MikeBusuttil/kitchenlighting/12v/references/spool.png

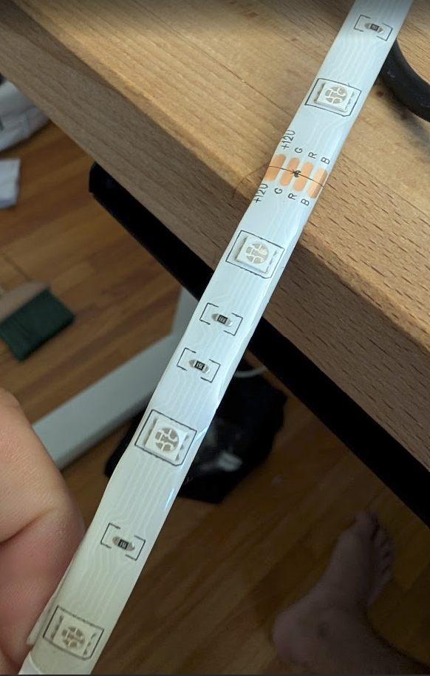
12v/references/spool.png
