MikeBusuttil/kitchenlighting/12v/references/driver.png

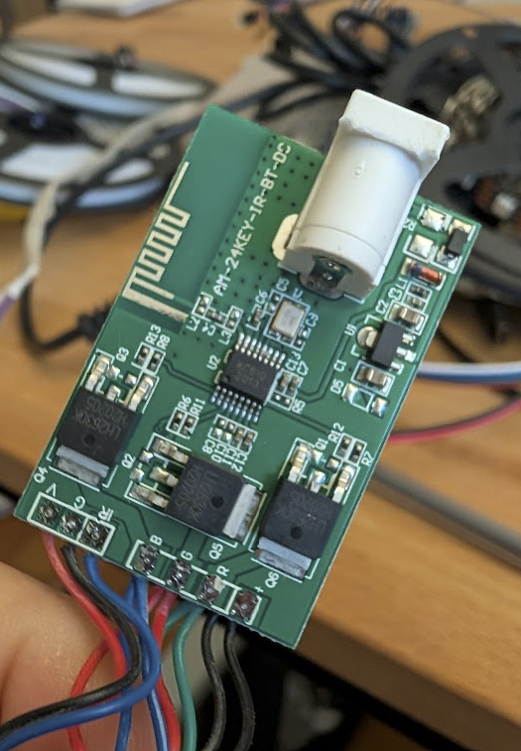
12v/references/driver.png
