MikeBusuttil/kitchenlighting/12v/shopping.csv

status | quantity_needed | suggested_order_quantity | description | manufacturer_part | estimated_order_cost_CAD | purchase_url | notes
minimum only | 3 | 3 | N-channel MOSFET; SOT-23-3; 30 V; direct 3.3 V control | AO3400A | 2.49 | https://www.digikey.ca/en/products/detail/alpha-omega-semiconductor-inc/AO3400A/1855772 | Minimum Q1-Q3, Alpha & Omega Semiconductor part. Solder each onto a SparkFun 00717 adapter listed below. SOT-23 pins: 1=G, 2=S, 3=D. Maximum on-resistance 48 milliohms at VGS=2.5 V, ID=3 A, 25 C. The headline 5.7 A rating depends on PCB copper and thermal conditions; it is not a breadboard or adapter rating. Keep the 25 cm/0.30 A combined load limit. DigiKey 785-1000-1-ND cut tape, CAD0.83 each; in stock when checked 2026-10-16. Datasheet: https://www.aosmd.com/res/data_sheets/AO3400A.pdf
minimum only | 3 | 3 | SOT-23 to DIP adapter; bare PCB; 0.300-inch row spacing | 00717 | 5.61 | https://www.digikey.ca/en/products/detail/sparkfun-electronics/00717/5318740 | Minimum A1-A3: SparkFun BOB-00717, DigiKey 1568-00717-ND. CAD1.87 each, CAD5.61 for three; in stock when checked 2026-10-16. Solder one AO3400A onto each bare board and fit two 61300311121 straight 1x3 headers per board, listed separately below. Board is 0.34 x 0.46 inch (8.64 x 11.68 mm), with two header rows 0.300 inch (7.62 mm) apart and 0.100-inch (2.54 mm) pin pitch. Mount headers underneath in columns e/f across the breadboard centre gap: A1 rows 42-44, A2 rows 48-50, A3 rows 54-56. Component-side top view, single drain lead facing left: Q1 source f42, drain e43, gate f44; Q2 source f48, drain e49, gate f50; Q3 source f54, drain e55, gate f56. Leave the other three pads empty and their header bank/rows isolated. The six-pad adapter numbering differs from the three-pin AO3400A package numbering; follow the drawn gate, drain and source connections. Inspect actual copper routes and check continuity before applying power. No current rating for the adapter is inferred from the MOSFET rating. Included in generated min.csv. Manufacturer: https://www.sparkfun.com/sparkfun-sot23-to-dip-adapter.html ; schematic: https://cdn.sparkfun.com/datasheets/BreakoutBoards/SparkFun_SOT23-DIP-Adapter-v10.pdf
minimum only | 6 | 6 | Straight male 1x3 header; 2.54 mm pitch; two per adapter | 61300311121 | 1.14 | https://www.digikey.ca/en/products/detail/w%C3%BCrth-elektronik/61300311121/4846825 | Minimum H1-H6: Wurth Elektronik WR-PHD, DigiKey 732-5316-ND. Two headers per SparkFun 00717 board, six total. Through-hole, straight, single row, three positions at 2.54 mm pitch; 6 mm mating pins. Solder the headers to the adapters with their long pins pointing down into the breadboard. CAD0.19 each, CAD1.14 for six; in stock when checked 2026-10-16. Included in generated min.csv.
minimum only | 3 | 10 | 2.2 kohm 1/4 W axial resistor | CF14JT2K20 | 0.43 | https://www.digikey.ca/en/products/detail/stackpole-electronics-inc/CF14JT2K20/1830358 | Minimum R1-R3: one series resistor from each Nano PWM output to its AO3400A gate; limits initial 3.3 V gate-charge current to approximately 1.5 mA. No pulldown resistors are fitted. Intended for the default low-frequency PWM. DigiKey CF14JT2K20CT-ND cut tape, ten cost CAD0.43, cheaper than three at CAD0.16 each; in stock when checked 2026-10-16. Seven are spares; only three are installed.
best-practice only | 3 | 3 | N-channel MOSFET; TO-220 | IRFZ44NPBF | 6.90 | https://www.digikey.ca/en/products/detail/infineon-technologies/IRFZ44NPBF/811772 | Best-practice Q1-Q3 only; minimum uses AO3400A on SparkFun 00717 DIP adapters. Use TC4427A gate drivers, not Nano direct gate drive. Front face, legs down: G-D-S; tab=D. Leads have 2.54 mm pitch but must occupy DIFFERENT ROWS. Fit varies: do not force thick TO-220 leads into breadboard; suitable pin adapters may be needed. MOSFET capacity does not increase the 25 cm/0.30 A combined breadboard load limit.
best-practice only | 2 | 2 | Dual non-inverting gate driver; DIP-8 | TC4427ACPA | 5.68 | https://www.digikey.ca/en/products/detail/microchip-technology/TC4427ACPA/418665 | Best-practice only; minimum uses direct Nano gate control. 12 V supply; accepts Nano 3.3 V signals. Three channels used; ground fourth input and leave fourth output open.
minimum only | 2 | 2 | Female RJ-11/RJ-14 modular jack; 6P4C; vertical through-hole | 615004144121 | 2.84 | https://www.digikey.ca/fr/products/detail/w%C3%BCrth-elektronik/615004144121/2627288 | J1/J2 in the minimum diagram; parallel RGB strip connections for the short-strip test. Both ports: pin 2 = +12 V, pin 3 = R, pin 4 = G, pin 5 = B. Positive pins use soldered pigtails from J0.1, bypassing breadboard contacts. Breadboard mounting is conceptual, not the physical footprint; use adapters or soldered leads if needed. Combined strip load remains at most 25 cm/0.30 A total. DigiKey 732-3172-ND; CAD 1.42 each checked 2026-10-16, before tax/shipping. Included in generated min.csv.
best-practice only | 3 | 10 | 100 ohm 1/4 W axial resistor | CF14JT100R | 0.43 | https://www.digikey.ca/en/products/detail/stackpole-electronics-inc/CF14JT100R/1830327 | Best-practice configuration only; omitted from minimum. One in series with each MOSFET gate; cut tape. Ten costs less than three at listed price breaks.
best-practice only | 6 | 10 | 10 kohm 1/4 W axial resistor | CF14JT10K0 | 0.43 | https://www.digikey.ca/en/products/detail/stackpole-electronics-inc/CF14JT10K0/1830374 | Best practice uses three driver-input pulldowns and three gate-to-source pulldowns; cut tape. Ten cost CAD0.43, checked 2026-10-16; quantity-one price CAD0.16 each. The minimum resistor requirement is listed separately.
best-practice only | 2 | 2 | 100 nF 50 V X7R radial ceramic capacitor | K104K15X7RF5TH5 | 0.86 | https://www.digikey.ca/en/products/detail/vishay-beyschlag-draloric-bc-components/K104K15X7RF5TH5/286723 | Best-practice configuration only; omitted from minimum. One close to each TC4427A between supply pin 6 and ground pin 3. Nonpolar; 5 mm lead spacing; cut tape.
best-practice only | 2 | 2 | 4.7 uF 25 V radial electrolytic capacitor | ECE-A1EKS4R7B | 0.86 | https://www.digikey.ca/en/products/detail/panasonic-industry/ECE-A1EKS4R7B/2689103 | Best-practice configuration only; omitted from minimum. One close to each TC4427A in parallel with 100 nF capacitor. Positive to pin 6; negative to pin 3. Preformed 5 mm leads; cut tape.
best-practice only / optional | 1 | 1 | 100 uF 25 V radial electrolytic capacitor | ECA-1EM101B | 0.49 | https://www.digikey.ca/en/products/detail/panasonic-industry/ECA-1EM101B/24632651 | Best-practice configuration only; omitted from minimum. Optional C7: positive h55 to +12 V, negative h57 to GND near breadboard power entry.
future full-strip build | 1 | 1 | 5.5 x 2.1 mm panel-mount DC barrel jack; 8 A | JACK-C-PANEL-8A(R) | 4.39 | https://www.digikey.ca/en/products/detail/globtek-inc/JACK-C-PANEL-8A-R/9837777 | Confirmed PSU plug size. Solder-tab panel jack for the full-strip assembly; NOT needed for the plug-in PoC. PoC uses breadboard-friendly J0 below.
existing | 1 | 0 | Arduino Nano 33 IoT |  | 0 |  | Both configurations. USB at top; c1-c15 and g1-g15; D3 red, D5 green, D6 blue. PWM high means ON. J0 supplies Nano VIN and the LED strip through parallel 12 V branches with common ground; strip current does not pass through Nano. Leave 3V3 and 5V/VUSB disconnected from the 12 V supply. Minimum drives AO3400A gates through 2.2 kohm series resistors; it deliberately has no pulldowns, so off at startup/reset is not guaranteed. Best practice drives TC4427A inputs; for USB-only programming with 12 V off, disconnect D3/D5/D6 from those driver inputs to avoid driving unpowered TC4427A inputs.
existing | 1 | 0 | 12 V 6 A regulated PSU |  | 0 |  | Both configurations retain J0 with the existing centre-positive 5.5 x 2.1 mm PSU plug. Existing PSU can power the short-strip PoC: 6 A is available capacity, not forced current or a low-current fault limit. Full 160-inch strip is 58.52 W/4.88 A and needs rated power wiring outside solderless contacts.
future full-strip build | 2 | 2 | Inline ATO/ATC blade fuse holder with 16 AWG leads; 15 A holder rating | BF353 | 12.40 | https://www.digikey.ca/en/products/detail/mpd-memory-protection-devices/BF353/8119223 | F0/F1 are omitted from the short-strip PoC. Revisit fuse topology and ratings for the installed wiring; a fuse is not a precise current limiter.
future full-strip build | 2 | 0 | ATO/ATC blade fuses for F0 and F1 |  |  |  | F0/F1 are omitted from the short-strip PoC. Revisit fuse topology and ratings for the installed wiring; a fuse is not a precise current limiter.
future full-strip build | 1 | 1 | 16 AWG silicone copper wire; 1 m red + 1 m black | FIT0584 | 5.06 | https://www.digikey.ca/en/products/detail/dfrobot/FIT0584/9559253 | Not used in the short-strip PoC. For later full-load power wiring; do not insert 16 AWG wire into breadboard contacts.
future full-strip build | 1 | 1 | Four independent circuits; screw-to-screw panel-mount terminal block; 30 A | 1546310-4 | 9.27 | https://www.digikey.ca/en/products/detail/te-connectivity-amp-connectors/1546310-4/2259446 | Not used in the short-strip PoC. For later full-load power wiring; do not insert 16 AWG wire into breadboard contacts.
assembly supplies | 1 | 0 | Multimeter, plug-in jumpers, insulated wire, soldering tools and heat-shrink for PoC |  |  |  | Both configurations use a 64-row solderless breadboard and suitable plug-in jumpers, plus suitably rated insulated wires soldered directly from J0 pin 1 to strip +. Minimum additionally requires soldering each AO3400A onto a SparkFun 00717 adapter and installing two separately supplied 61300311121 straight 1x3 headers per adapter. Disconnect all power before soldering; insulate and strain-relieve power joints. Check the assembled adapter pin mapping with a meter before inserting it into the breadboard. Best practice links the left/right +12 V and ground rails at the top and bridges all four midpoint breaks. Minimum feeds the left +12 V rail from J0 with a58 to L+58 and the lower-left ground rail with a60 to L-60. B1 bridges the left +12 V midpoint break; B4 bridges the right ground midpoint break. A ground cross-link joins L-39 to R-39. Both right +12 V rail halves and the upper-left ground rail are unused; there are no driver-ground links. Nano VIN connects at a15 to L+15; minimum Nano GND connects at j12 to R-12. Strip + bypasses breadboard rails. Minimum has no driver supply branches.
metadata |  |  | Recorded CAD estimates from 2026-10-11 and 2026-10-16; minimum MOSFETs, resistors, adapters and headers checked 2026-10-16 |  |  |  | Prices before tax/shipping; stock/prices can change. Minimum DigiKey subtotal CAD13.66: three AO3400A CAD2.49, three SparkFun 00717 adapters CAD5.61, six 61300311121 headers CAD1.14, ten 2.2 kohm resistors CAD0.43 (three fitted), J0 CAD1.15, and two RJ-11 jacks CAD2.84. MOSFET, resistor, adapter and header prices checked 2026-10-16; connector prices reuse recorded estimates. All three adapters and all six headers are included in generated min.csv; no separate adapter order is needed. Best practice remains CAD16.80 including optional C7 and ten of each resistor value. Existing hardware and assembly supplies are excluded. Obtain current pricing and shipping at checkout.
existing | 1 | 0 | 12 V common-positive RGB strip; planned 160 inches total |  | 0 |  | Both configurations: start with one marked cut segment; maximum 25 cm gives 3.6 W/0.30 A at full white, approximately 0.10 A per color, plus controller draw. Verify actual current; cut only at marked pads. Strip + connects directly to J0 pin 1 via a soldered insulated wire; row 40 is unused. Best-practice strip leads: a41 green, a42 red, a43 blue. Minimum exposes the same color nets on J1/J2: pin 3 red, pin 4 green, pin 5 blue; pin 2 positive connects through soldered pigtails to J0.1. Return current still passes through breadboard contacts; the positive bypass does not increase the load limit. Full 160 inches=4.064 m/58.52 W/4.88 A is for later rated wiring; higher-current MOSFETs do not make the breadboard suitable for that load. Sections connect in parallel to like pads.
required for both configurations | 1 | 1 | Breadboard-friendly 2.1 mm DC barrel jack; thin-pin type | Adafruit 373 / PJ-102AH | 1.15 | https://www.digikey.ca/en/products/detail/same-sky-formerly-cui-devices/PJ-102AH/408448 | Both configurations retain J0; replaces panel-mount jack for PoC. DigiKey CP-102AH-ND; CAD 1.15 checked 2026-10-16, before tax/shipping. Included in generated min.csv. Manufacturer specifies breadboard-friendly pins: https://www.adafruit.com/product/373 . Minimum: centre-positive pin 1 at c58, sleeve ground pin 2 at c60, and unused switched contact pin 3 at e59. Best practice retains pin 1 at b58, pin 2 at b60, and unused pin 3 at d59. Minimum Nano supply jumpers connect a58 to L+58 and a60 to L-60. Solder the strip-positive wire to the actual pin 1 terminal, not a breadboard hole such as a58 or e58. Insulate and strain-relieve the joint; remove the jack from the breadboard before soldering. Gently form pins if needed; verify contact identity with unplugged meter. Drawing: https://cdn-shop.adafruit.com/datasheets/21mmdcjackDatasheet.pdf
PoC design note |  |  | Best-practice and minimum short-strip prototypes with direct strip-positive wiring |  |  |  | Both retain J0 and parallel Nano VIN/strip supply branches. Strip + is soldered directly to J0 pin 1, bypassing positive breadboard contacts; strip returns still use breadboard contacts. Row 40 is unused. The load limit remains 25 cm/0.30 A total. Minimum uses three AO3400A MOSFETs on SparkFun 00717 adapters with six 61300311121 straight 1x3 headers, three 2.2 kohm series gate resistors, and two parallel RJ-11 jacks J1/J2. It omits gate drivers, added capacitors and pulldowns as requested; the gates can float during startup/reset. Use the default low-frequency PWM; these gate resistors are not intended for high-frequency switching. Best practice retains three IRFZ44NPBF MOSFETs, two TC4427A drivers, three driver-input pulldowns, three 100 ohm gate resistors, three gate-to-source pulldowns, driver 100 nF/4.7 uF bypass pairs, and optional C7. No F0/F1 holders or external J12 block in either PoC. Start with one strip segment, up to 25 cm after checking current. Full strip at low PWM brightness still has high-current pulses; do not use that as a substitute for a short load.
