MikeBusuttil/kitchenlighting/5v/shopping.csv

status | quantity_needed | suggested_order_quantity | description | manufacturer_part | estimated_order_cost_CAD | purchase_url | notes
best-practice only | 1 | 1 | 3.3 V to 5 V logic buffer; DIP-14 | SN74AHCT125N | 1.60 | https://www.digikey.ca/en/products/detail/texas-instruments/SN74AHCT125N/375798 | Best-practice configuration only; omitted from minimum. U1; use the through-hole N package. At 5 V supply its input HIGH threshold is 2.0 V, suitable for the Nano's 3.3 V outputs. Two channels carry data and clock. Datasheet: https://www.ti.com/lit/ds/symlink/sn74ahct125.pdf
best-practice only | 2 | 2 | 33 ohm 1/4 W axial resistor | CF14JT33R0 | 0.32 | https://www.digikey.ca/en/products/detail/stackpole-electronics-inc/CF14JT33R0/1741397 | Best-practice configuration only; omitted from minimum. R3/R4; one in series with each buffered data/clock output. Cut tape; listed cost is for two at CAD0.16 each. These are signal resistors, not LED power-current limiters.
best-practice only | 2 | 2 | 10 kohm 1/4 W axial resistor | CF14JT10K0 | 0.32 | https://www.digikey.ca/en/products/detail/stackpole-electronics-inc/CF14JT10K0/1830374 | Best-practice configuration only; omitted from minimum. R1/R2; input pull-downs for data and clock. Cut tape; listed cost is for two at CAD0.16 each. Reuse suitable resistors already owned.
best-practice only | 1 | 1 | 100 nF 50 V X7R radial ceramic capacitor | K104K15X7RF5TH5 | 0.43 | https://www.digikey.ca/en/products/detail/vishay-beyschlag-draloric-bc-components/K104K15X7RF5TH5/286723 | Best-practice configuration only; omitted from minimum. C1; bypass U1's 5 V supply to common ground, close to the chip. Nonpolarized; 5 mm lead pitch. Cut tape.
best-practice only | 1 | 1 | 1000 uF 10 V radial electrolytic capacitor | EEU-FC1A102B | 1.59 | https://www.digikey.ca/en/products/detail/panasonic-industry/EEU-FC1A102B/6109529 | Best-practice configuration only; omitted from minimum. C2; positive to LED +5 V, negative/striped lead to common GND. 10 mm body diameter, 5 mm lead pitch; fits c46/c48. Buy one cut-tape piece. Manufacturer dimensions: https://industrial.panasonic.com/ww/products/pt/aluminum-cap-lead/models/EEUFC1A102B
best-practice only | 1 | 1 | USB-C female connector breakout for 5 V power; breadboard header included | Adafruit 4090 | 4.42 | https://www.digikey.ca/en/products/detail/adafruit-industries-llc/4090/9951930 | Best-practice configuration only; omitted from minimum. J0; DigiKey part 1528-2873-ND. Solder the included 8-pin header, then mount in b54-b61 with the USB-C connector facing left. GND b54 feeds R-54 through e54; VBUS b55 feeds R+55 through e55. The remaining six header pads are unused externally. Includes two onboard 5.1 kohm CC pull-down resistors for a USB-C source; no separate CC resistors required. Use ordinary 5 V USB power; no higher-voltage PD trigger is needed. Manufacturer: https://www.adafruit.com/product/4090 . Price checked 2026-10-16.
existing | 1 | 0 | Arduino Nano 33 IoT | ABX00027 | 0 |  | Both configurations. USB at top, headers c1-c15 and g1-g15. D11 data, D13 clock. Minimum: power through the Nano's USB socket and close its onboard VUSB solder jumper SJ1 to enable its 5V/VUSB header c12; connect a12 to L+12 and a14 to L-14, then power the LED section from those left rails. Leave VIN/c15 unconnected in minimum. Best practice: J0 supplies the Nano, LEDs, and buffer; connect VIN c15 to the shared +5 V rail using a15 to L+15 and GND c14 to common ground using a14 to L-14. Keep SJ1 open and c12 unconnected; Nano micro-USB is for programming. Leave 3V3/c2 unconnected to the breadboard supply in both. Minimum data/clock connect directly to the strip; 3.3 V signal recognition is not guaranteed.
existing / verify available | 1 | 0 | USB cable for the Nano 33 IoT micro-USB socket |  | 0 |  | Both configurations. Use a data-capable cable for programming. Minimum: this cable supplies both Nano and the short LED section through the enabled VUSB header. Best practice: use this cable only for programming; J0 supplies the Nano through VIN during normal operation.
existing / verify available | 1 | 0 | USB power cable with USB-C plug for J0 |  | 0 |  | Best-practice configuration only; omitted from minimum. Reuse a cable matching the existing 5 V supply output, with USB-C at J0. Verify that a suitable cable is available; no cable is included in the generated purchase list.
existing / verify connector and rating | 1 | 0 | Regulated 5 V PSU |  | 0 |  | Minimum: power the Nano through USB and supply the short LED section from its enabled 5V/VUSB header. Budget up to 0.30 A for 1-5 pixels plus Nano current, within the USB source/cable rating. Best practice: supply J0 through USB-C to power the Nano via VIN, the LED section, and the buffer from the shared 5 V rails; use a suitable 5 V USB supply with at least 1 A capacity. Nano micro-USB is only needed for programming. Current rating is available capacity, not current forced into the load.
existing | 1 | 0 | 64-row solderless breadboard and suitable jumper wires |  | 0 |  | Both configurations. Standard a-e and f-j terminal banks, separated by the centre gap. Best practice: both + rails carry 5 V and both - rails GND; bridge all four midpoint breaks and link left/right rails as drawn. Minimum: use the left +5 V and GND rails; bridge L+31 to L+34 and L-31 to L-34. Connect b43 to L+43 and b40 to L-40 for the LED section. Only a physically short LED section belongs on these power contacts.
existing | 1 | 0 | APA102 LED strip; 160 inches planned, 60 LEDs per metre |  | 0 |  | Both configurations. Start with 1-5 physically connected pixels; five pixels are about 8.3 cm and allow a conservative 0.30 A LED budget at 60 mA/pixel, plus the Nano/buffer on their branches. Connect the INPUT end: a40 GND, a41 CI, a42 DI, a43 +5 V. CO/DO are downstream outputs. Cut only at marked pads. Minimum omits the buffer and all resistors/capacitors; direct 3.3 V control may not work with the particular strip.
future full-strip build | 1 | 0 | Power distribution and supply sized for the complete APA102 strip |  |  |  | 160 inches = 4.064 m, about 244 pixels at 60/m. A conservative 60 mA/pixel planning value gives about 14.6 A at 5 V before controller draw; actual variant/current must be checked. Full-strip power needs suitable external wiring and injection, not the breadboard or Nano USB path. Guide: https://learn.adafruit.com/adafruit-dotstar-leds/power-and-connections
assembly supplies / verify available | 1 | 0 | Multimeter, soldering supplies and suitable plug-in strip connector or leads |  |  |  | Minimum: close the Nano VUSB solder jumper SJ1 and verify 5 V at c12 before connecting the strip. Best practice: solder the included header to J0, verify its VBUS/GND pins, and keep Nano SJ1 open. Both: verify strip input pad order. The strip connector type and pitch are not confirmed, so no mating connector is guessed. A cut strip section may require soldered leads or a correctly matched solderless strip clip. These are assembly supplies, not additional circuit components.
metadata |  |  | Passive/buffer prices checked 2026-10-12; USB-C breakout checked 2026-10-16; short-strip PoC |  |  |  | CAD estimates before tax/shipping; stock and prices can change. Listed new best-practice parts total CAD8.68 including the USB-C breakout. Minimum needs no new circuit parts and its generated min.csv contains only the upload column headings. Both configurations reuse the existing Nano, its USB cable, short LED section, regulated 5 V PSU, breadboard, and jumpers. Best practice also assumes an existing suitable USB-C cable. No barrel jack or USB-A barrel cable is required.
