MikeBusuttil/kitchenlighting/12v/min.csv

Quantity | DigiKey Part Number | Manufacturer Part Number | Customer Reference
3 | 785-1000-1-ND | AO3400A | Q1 Q2 Q3
3 | 1568-00717-ND | 00717 | A1 A2 A3
6 | 732-5316-ND | 61300311121 | H1 H2 H3 H4 H5 H6
10 | CF14JT2K20CT-ND | CF14JT2K20 | R1 R2 R3
1 | CP-102AH-ND | PJ-102AH | J0
2 | 732-3172-ND | 615004144121 | J1 J2
