MikeBusuttil/kitchenlighting/5v/best.csv

Quantity | DigiKey Part Number | Manufacturer Part Number | Customer Reference
1 | 296-4655-5-ND | SN74AHCT125N | U1
2 | CF14JT33R0CT-ND | CF14JT33R0 | R3 R4
2 | CF14JT10K0CT-ND | CF14JT10K0 | R1 R2
1 | BC1101CT-ND | K104K15X7RF5TH5 | C1
1 | P19631CT-ND | EEU-FC1A102B | C2
1 | 1528-2873-ND | 4090 | J0 USB-C breakout (header included)
