MikeBusuttil/kitchenlighting/TODO.md

- build it
  - measure current at full brightness to see if its going to be a problem
    - Measure combined length required & cut excess
    - assemble all parts
      - get magnet for breadboard
        - see where Im gonna mount it
  - upload the sketch
    - test those commands
      - dockerize all those random packages

## v1

- mount lights under dishes
- mount lights above air fryer

- tap into sink light power (at bulb)
  - mount power source & controller (hidden)
  - connect PSU to outlet
- connect dish lights to power source
  - fish through cabinets against front face with no visible signs
- connect air fryer lights
- configure controller to output the desired temperature and brightness
  - Figure out temp & brightness connection 

Phase 2:
- allow color/brightness adjustments

Phase 3:
- living room mood lighting:
  - behind cabinet
  - inside console
- trigger by unused vestibule switch
- control color through app
- include kitchen counter lights
