MikeBusuttil/kitchenlighting/12v/pcb/pcb-layout.pdf

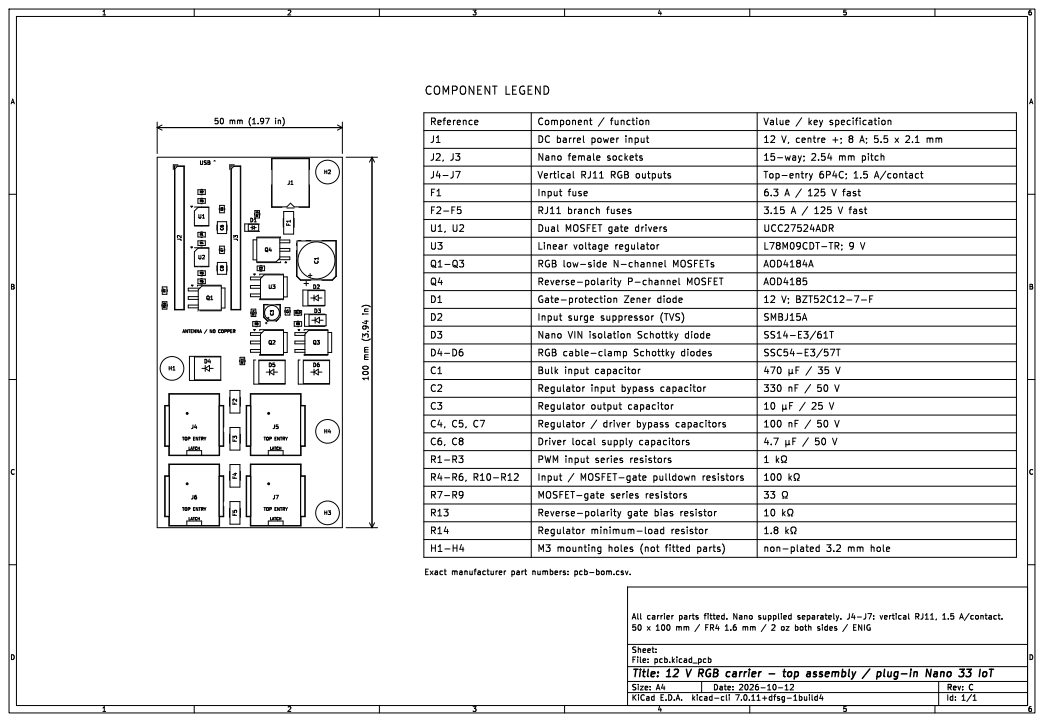
[picture p3: page 1]

USB ^ ANTENNA / NO COPPER Q1

Reference | Component / function | Value / key specification
J1 | DC barrel power input | 12 V, centre +; 8 A; 5.5 x 2.1 mm
J2, J3 | Nano female sockets | 15-way; 2.54 mm pitch
J4-J7 | Vertical RJ11 RGB outputs

part numbers: D1 | pcb-bom.csv. Gate-protection Zener diode | Top-entry 6P4C; 1.5 A/contact Exact manufacturer 12 V; BZT52C12-7-F

Input fuse | 6.3 A / 125 V fast

F2-F5 | | | | | 3.15 A / 125 V fast
U1, U2 | Dual MOSFET gate drivers | | | | UCC27524ADR
U3 | | | | | | L78M09CDT-TR; 9 V
Q1-Q3 | RGB low-side N-channel MOSFETs | | | | | AOD4184A
Q4 | Reverse-polarity P-channel MOSFET | AOD4185

D2 | Input surge suppressor (TVS)
D3 | Nano VIN isolation Schottky diode | SS14-E3/61T
D4-D6 | | | | | | | SSC54-E3/57T
C1 | Bulk input capacitor | | | | | | 470 þÿµF/ 35 V
C2 | Regulator input bypass capacitor | | | | | | 330 nF / 50 V

C4, C5, C7 | Regulator / driver bypass capacitors | 100 nF / 50 V
C6, C8 | Driver local supply capacitors | 4.7 þÿµF/ 50 V
R1-R3 | PWM input series resistors | 1 þÿk©
R4-R6, R10-R12 | Input / MOSFET-gate pulldown resistors | 100 þÿk©
R7-R9 | MOSFET-gate series resistors | 33 þÿ©
R13 | Reverse-polarity gate bias resistor | 10 þÿk©
R14 | Regulator minimum-load resistor | 1.8 þÿk©

TOP ENTRY | TOP ENTRY LATCH

M3 mounting holes (not fitted parts) | non-plated 3.2 mm hole
