MikeBusuttil/kitchenlighting/12v/pcb/pcb.pdf

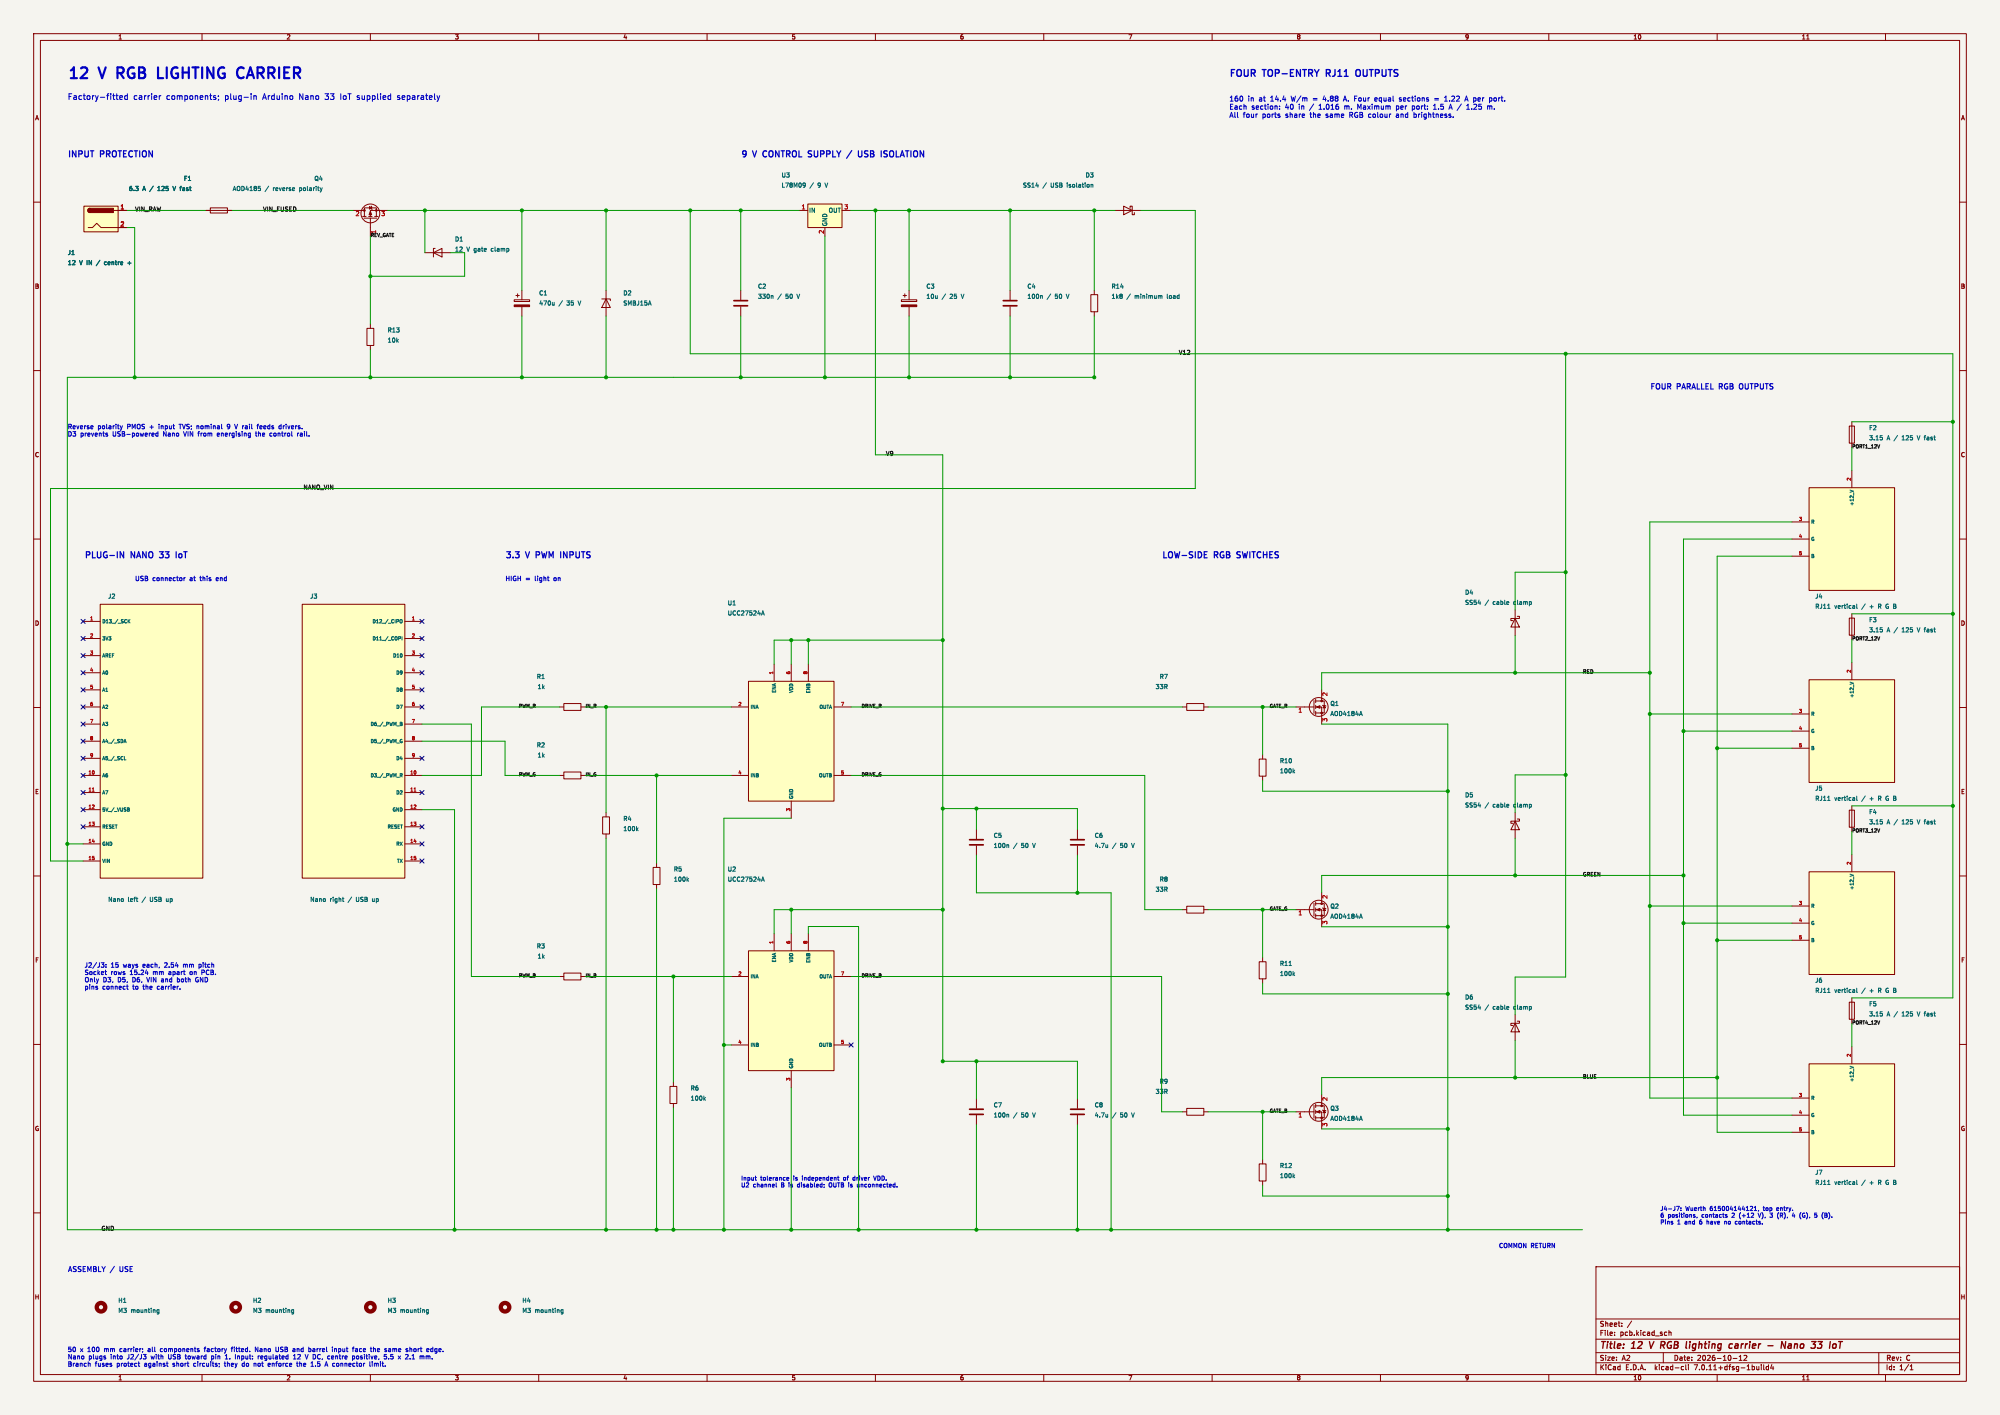
[picture p4: page 1]

FOUR TOP-ENTRY RJ11 OUTPUTS

160 in at 14.4 W/m = 4.88 A. Four equal sections = 1.22 A per port. Each section: 40 in / 1.016 m. Maximum per port: 1.5 A / 1.25 m. All four ports share the same RGB colour and brightness.

9 V CONTROL SUPPLY / USB ISOLATION

IN_B GND
pins connect to the carrier.
