MikeBusuttil/kitchenlighting/(list of files, drawings)

Other design files:
12v/pcb/pcb-checks.json
12v/pcb/pcb-routes.json
