MikeBusuttil/kitchenlighting/12v/pcb/pcb.kicad_pcb

## KiCad design 12v/pcb/pcb.kicad_pcb (2026-10-13)

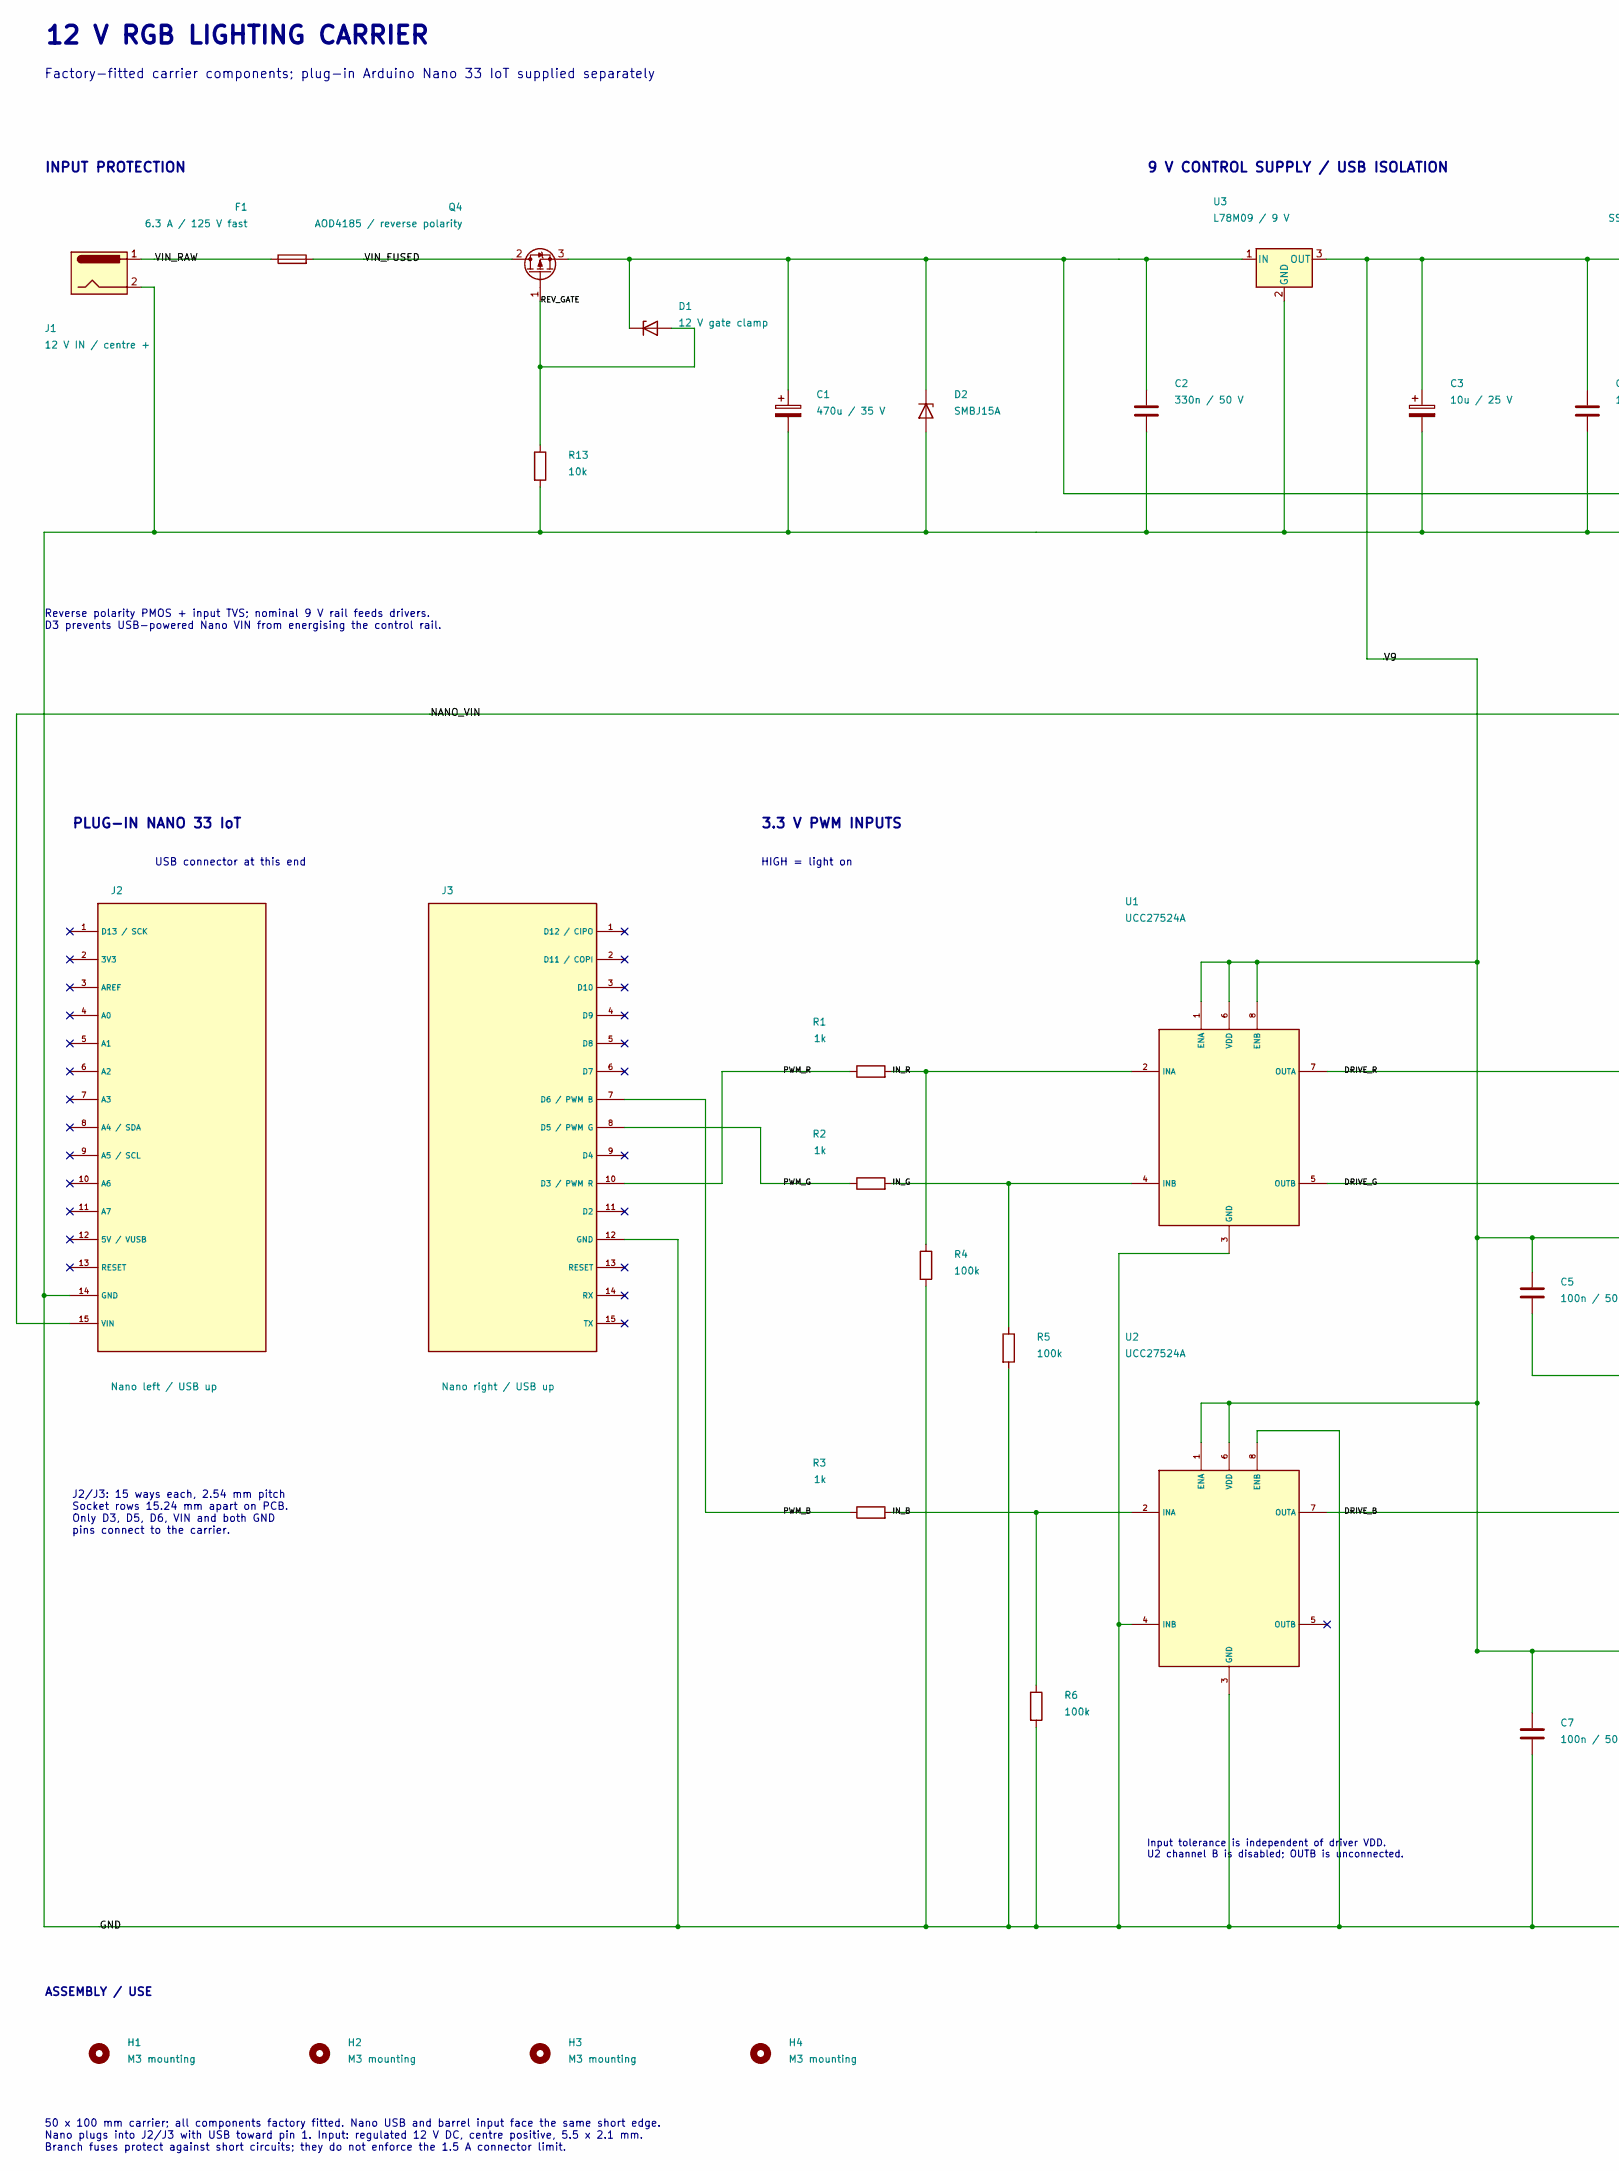
[picture p5: schematic pcb.kicad_sch, 12 V RGB lighting carrier - Nano 33 IoT, part in row 1, column 1]

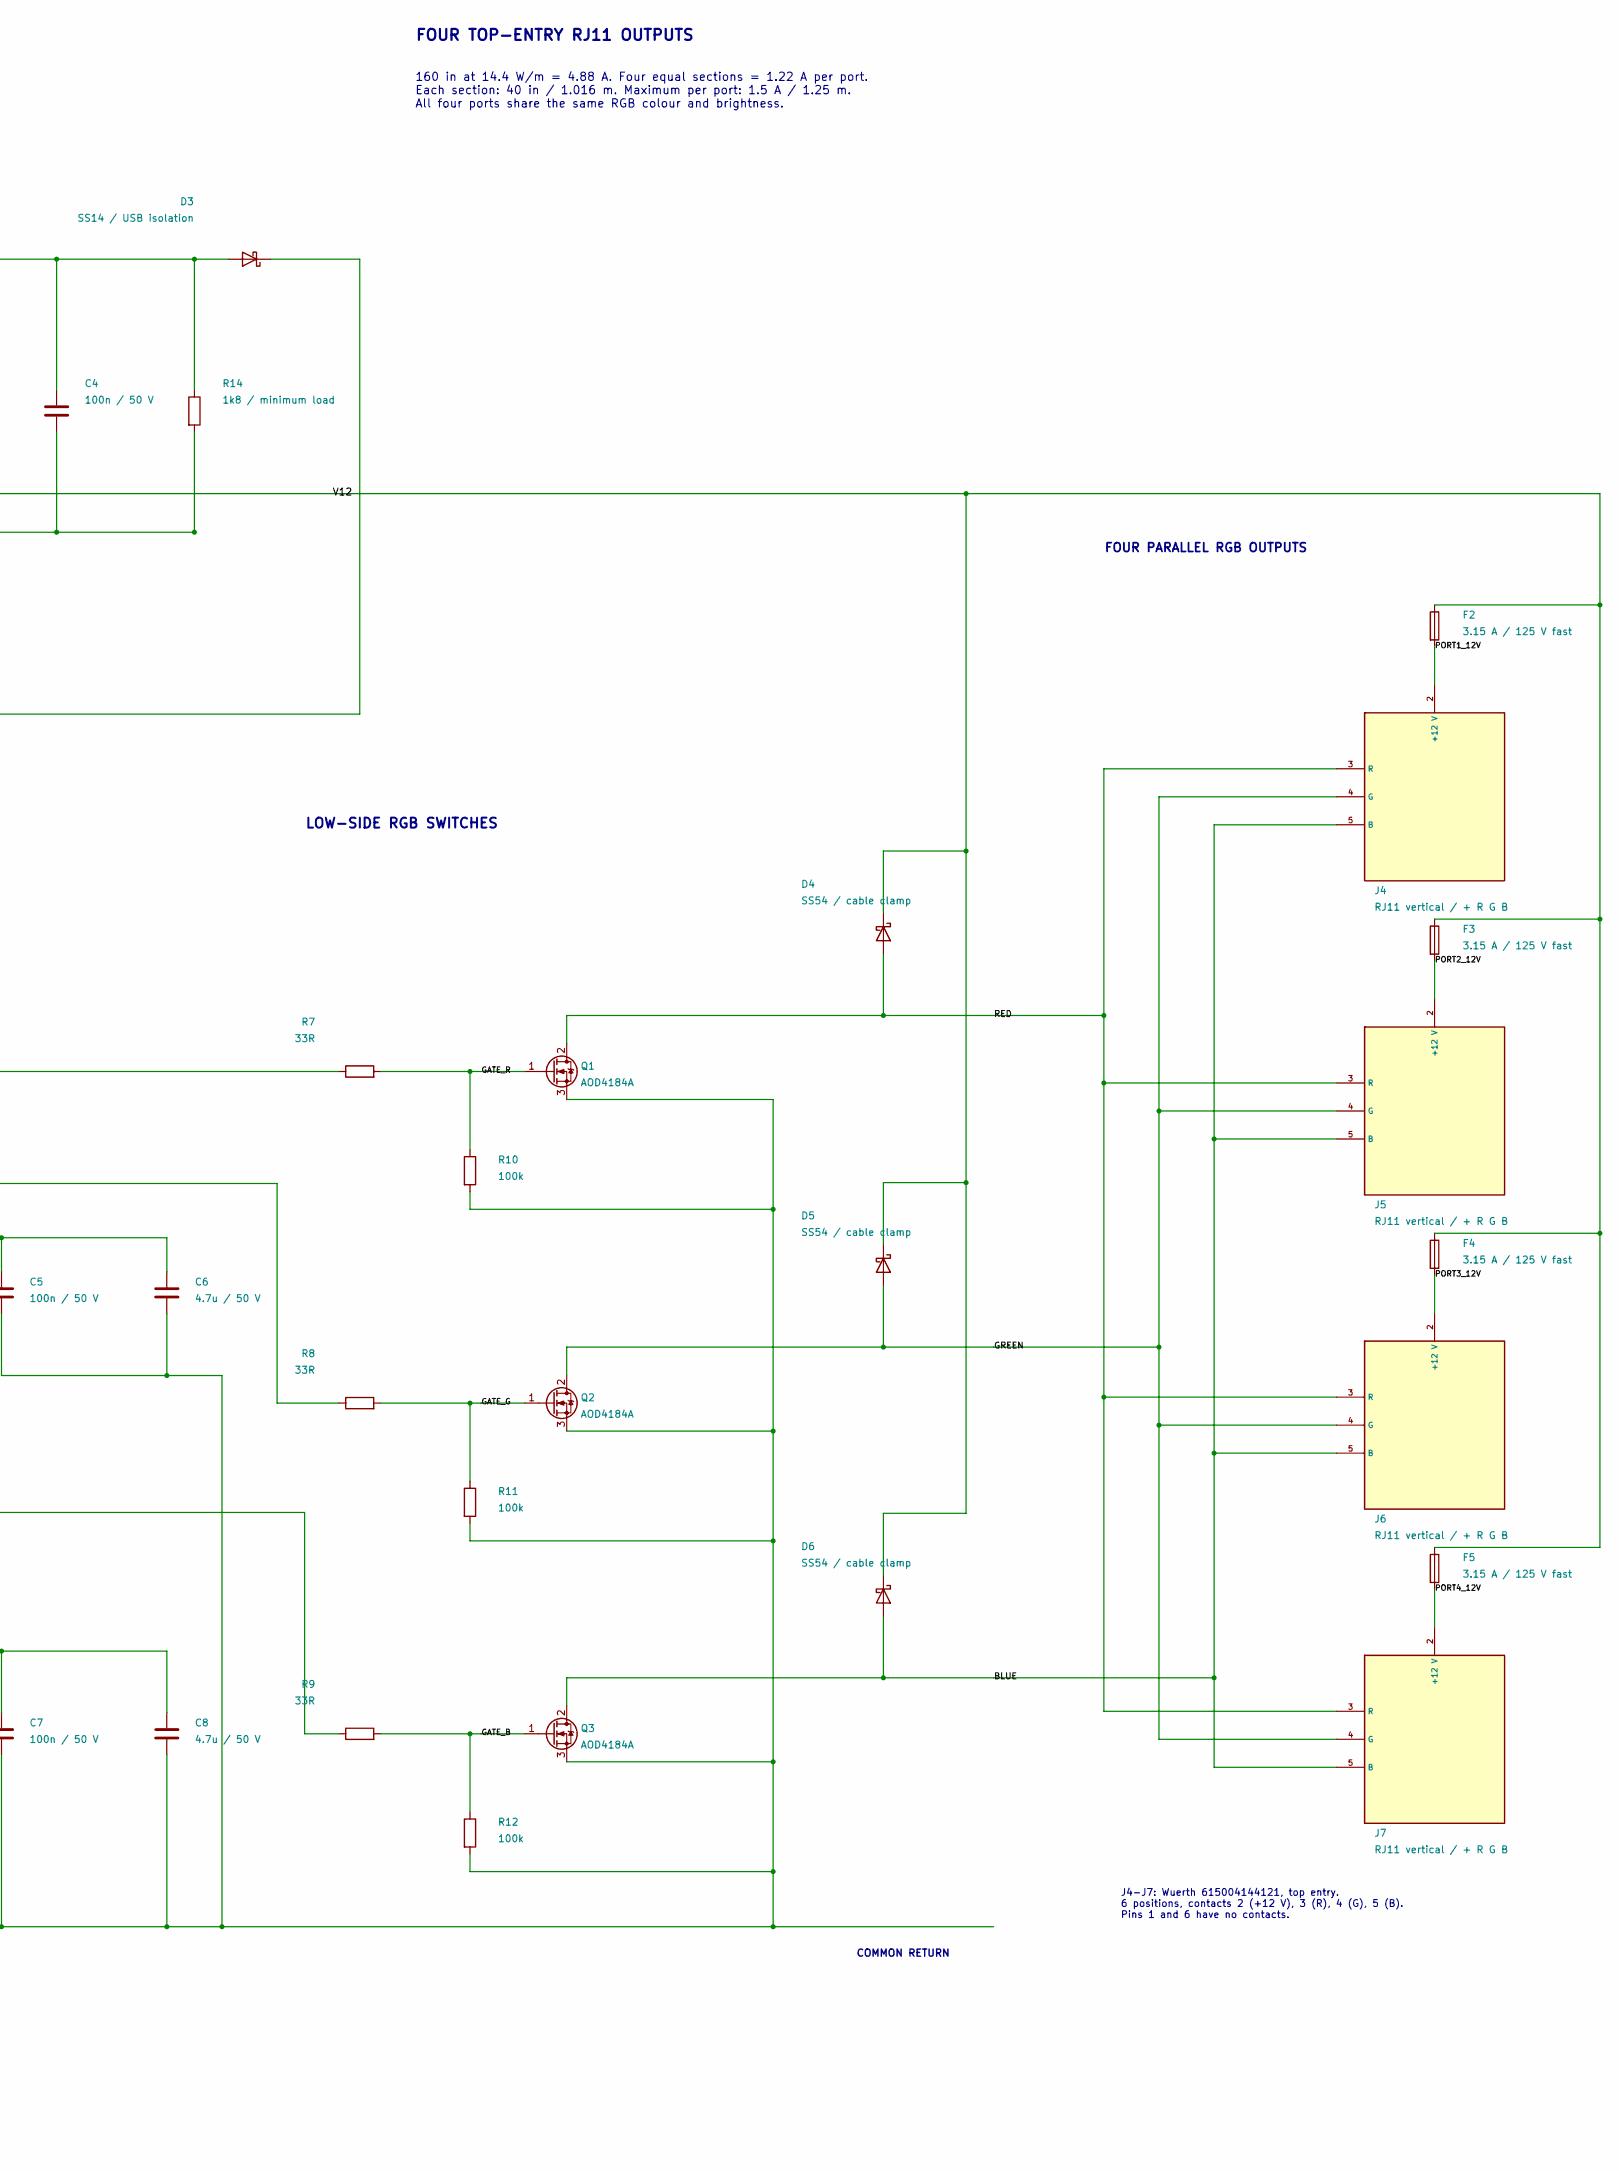
[picture p6: schematic pcb.kicad_sch, 12 V RGB lighting carrier - Nano 33 IoT, part in row 1, column 2]

Parts:
C1: 470u / 35 V; CP_Elec_10x10.5; MPN EEHZL1V471P
C2: 330n / 50 V; C_0805_2012Metric; MPN GRM21BR71H334KA01L
C3: 10u / 25 V; CP_Elec_4x5.8; MPN EEEFK1E100R
C4, C5, C7: 100n / 50 V; C_0805_2012Metric; MPN GRM21BR71H104KA01L
C6, C8: 4.7u / 50 V; C_1210_3225Metric; MPN GRM32ER71H475KA88L
D1: 12 V gate clamp; D_SOD-123; MPN BZT52C12-7-F
D2: SMBJ15A; D_SMB; MPN SMBJ15A
D3: SS14 / USB isolation; D_SMA; MPN SS14-E3/61T
D4, D5, D6: SS54 / cable clamp; D_SMC; MPN SSC54-E3/57T
F1: 6.3 A / 125 V fast; Fuse_Littelfuse-NANO2-451_453; MPN 045106.3MRL
F2, F3, F4, F5: 3.15 A / 125 V fast; Fuse_Littelfuse-NANO2-451_453; MPN 04513.15MRL
H1, H2, H3, H4: M3 mounting; MountingHole_3.2mm_M3
J1: 12 V IN / centre +; BarrelJack_CUI_PJ-063AH_Horizontal; MPN PJ-063AH
J2: Nano left / USB up; Socket_Samtec_SSQ-115-01-G-S; MPN SSQ-115-01-G-S
J3: Nano right / USB up; Socket_Samtec_SSQ-115-01-G-S; MPN SSQ-115-01-G-S
J4, J5, J6, J7: RJ11 vertical / + R G B; RJ11_Wuerth_615004144121; MPN 615004144121
Q1, Q2, Q3: AOD4184A; TO-252-3_TabPin2; MPN AOD4184A
Q4: AOD4185 / reverse polarity; TO-252-3_TabPin2; MPN AOD4185
R1, R2, R3: 1k; R_0805_2012Metric; MPN RC0805FR-071KL
R4, R5, R6, R10, R11, R12: 100k; R_0805_2012Metric; MPN RC0805FR-07100KL
R7, R8, R9: 33R; R_0805_2012Metric; MPN RC0805FR-0733RL
R13: 10k; R_0805_2012Metric; MPN RC0805FR-0710KL
R14: 1k8 / minimum load; R_0805_2012Metric; MPN RC0805FR-071K8L
U1, U2: UCC27524A; SOIC-8_3.9x4.9mm_P1.27mm; MPN UCC27524ADR
U3: L78M09 / 9 V; TO-252-3_TabPin2; MPN L78M09CDT-TR

Connections:
BLUE: D6.2 (A), J4.5 (B), J5.5 (B), J6.5 (B), J7.5 (B), Q3.2 (D)
DRIVE_B: R9.1, U2.7 (OUTA)
DRIVE_G: R8.1, U1.5 (OUTB)
DRIVE_R: R7.1, U1.7 (OUTA)
GATE_B: Q3.1 (G), R9.2, R12.1
GATE_G: Q2.1 (G), R8.2, R11.1
GATE_R: Q1.1 (G), R7.2, R10.1
GND: C1.2, C2.2, C3.2, C4.2, C5.2, C6.2, C7.2, C8.2, D2.2 (A), J1.2, J2.14 (GND), J3.12 (GND), Q1.3 (S), Q2.3 (S), Q3.3 (S), R4.2, R5.2, R6.2, R10.2, R11.2, R12.2, R13.2, R14.2, U1.3 (GND), U2.3 (GND), U2.4 (INB), U2.8 (ENB), U3.2 (GND)
GREEN: D5.2 (A), J4.4 (G), J5.4 (G), J6.4 (G), J7.4 (G), Q2.2 (D)
IN_B: R3.2, R6.1, U2.2 (INA)
IN_G: R2.2, R5.1, U1.4 (INB)
IN_R: R1.2, R4.1, U1.2 (INA)
NANO_VIN: D3.1 (K), J2.15 (VIN)
PORT1_12V: F2.2, J4.2 (+12 V)
PORT2_12V: F3.2, J5.2 (+12 V)
PORT3_12V: F4.2, J6.2 (+12 V)
PORT4_12V: F5.2, J7.2 (+12 V)
PWM_B: J3.7 (D6 / PWM B), R3.1
PWM_G: J3.8 (D5 / PWM G), R2.1
PWM_R: J3.10 (D3 / PWM R), R1.1
RED: D4.2 (A), J4.3 (R), J5.3 (R), J6.3 (R), J7.3 (R), Q1.2 (D)
REV_GATE: D1.2 (A), Q4.1 (G), R13.1
V9: C3.1, C4.1, C5.1, C6.1, C7.1, C8.1, D3.2 (A), R14.1, U1.1 (ENA), U1.6 (VDD), U1.8 (ENB), U2.1 (ENA), U2.6 (VDD), U3.3 (OUT)
V12: C1.1, C2.1, D1.1 (K), D2.1 (K), D4.1 (K), D5.1 (K), D6.1 (K), F2.1, F3.1, F4.1, F5.1, Q4.3 (S), U3.1 (IN)
VIN_FUSED: F1.2, Q4.2 (D)
VIN_RAW: F1.1, J1.1

Notes on the sheet:
12 V RGB LIGHTING CARRIER
Factory-fitted carrier components; plug-in Arduino Nano 33 IoT supplied separately
FOUR TOP-ENTRY RJ11 OUTPUTS
160 in at 14.4 W/m = 4.88 A. Four equal sections = 1.22 A per port. Each section: 40 in / 1.016 m. Maximum per port: 1.5 A / 1.25 m. All four ports share the same RGB colour and brightness.
COMMON RETURN
INPUT PROTECTION
9 V CONTROL SUPPLY / USB ISOLATION
Reverse polarity PMOS + input TVS; nominal 9 V rail feeds drivers. D3 prevents USB-powered Nano VIN from energising the control rail.
PLUG-IN NANO 33 IoT
USB connector at this end
J2/J3: 15 ways each, 2.54 mm pitch Socket rows 15.24 mm apart on PCB. Only D3, D5, D6, VIN and both GND pins connect to the carrier.
3.3 V PWM INPUTS
HIGH = light on
Input tolerance is independent of driver VDD. U2 channel B is disabled; OUTB is unconnected.
LOW-SIDE RGB SWITCHES
FOUR PARALLEL RGB OUTPUTS
J4-J7: Wuerth 615004144121, top entry. 6 positions, contacts 2 (+12 V), 3 (R), 4 (G), 5 (B). Pins 1 and 6 have no contacts.
ASSEMBLY / USE
50 x 100 mm carrier; all components factory fitted. Nano USB and barrel input face the same short edge. Nano plugs into J2/J3 with USB toward pin 1. Input: regulated 12 V DC, centre positive, 5.5 x 2.1 mm. Branch fuses protect against short circuits; they do not enforce the 1.5 A connector limit.

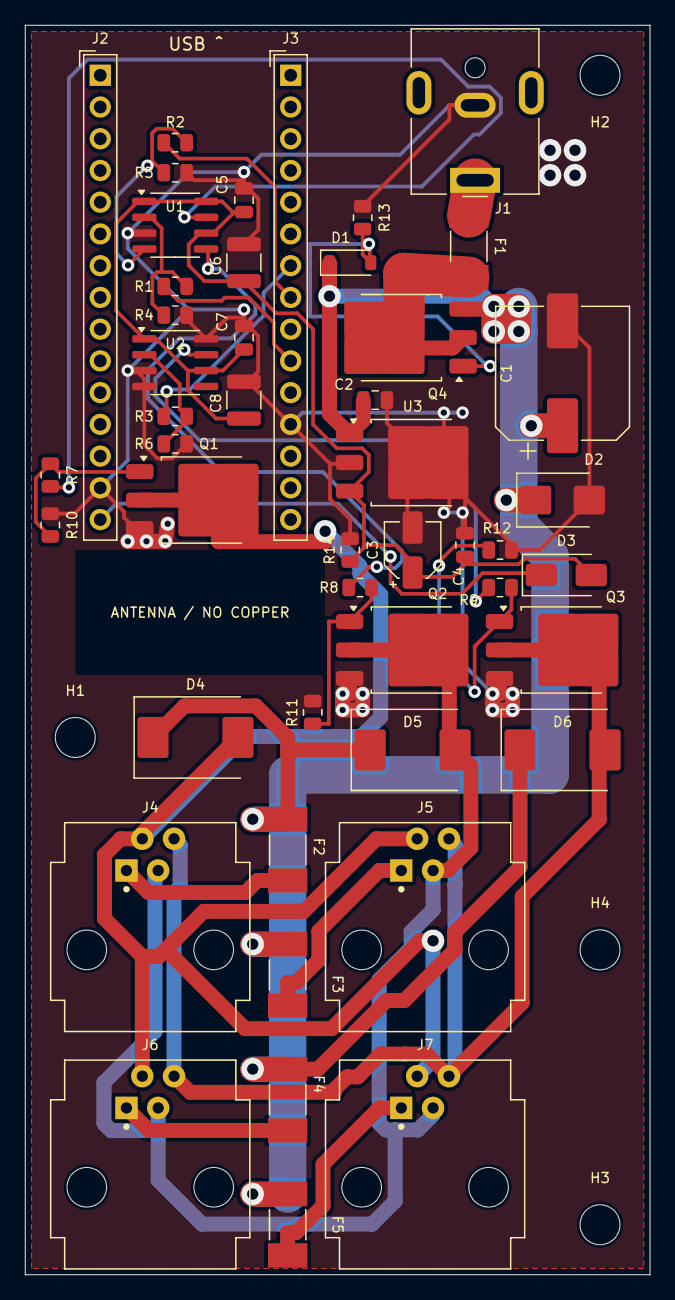
[picture p7: board pcb.kicad_pcb from above]

Board: 2 copper layers, 50.0 x 100.0 mm, 51 parts (0 on the bottom side), 26 nets.
