MikeBusuttil/kitchenlighting/(commit log)

2026-10-12 PoC round 1
    [kitchen-lighting-12v-shopping.csv, kitchen-lighting-5v-shopping.csv]
2026-10-12 5v minimal
    [kitchen-lighting-5v-shopping.csv]
2026-10-12 12v min
    [kitchen-lighting-12v-shopping.csv]
2026-10-12 diagram labelling, file renaming
    [shopping.csv]
2026-10-12 12v current improving
    [shopping.csv]
2026-10-13 12v pcb spec
2026-10-13 12v pcb
    [pcb-bom.csv, pcb-checks.json, pcb-positions.csv, pcb-routes.json, pcb.kicad_pcb, pcb.kicad_sch]
2026-10-16 breadboard shorter wires
    [shopping.csv]
2026-10-16 shopping lists, 5v PSU update
    [best.csv, min.csv, shopping.csv]
2026-10-16 PoC round 3
    [min.csv, shopping.csv]
2026-10-17 PoC round 3 ready for assembly
    [min.csv, shopping.csv]
2026-10-17 12v min sketch
